gonium/esp8266-dht22-sensor/(threads)

Thread 1 (2017-02-25):

src/main.cpp:17:17: fatal error: DHT.h: No such file or directory

lfrancois, 2017-02-25:
It's my first experience with platformio and with the esp8266 so I am very new to it. When I try to run a platformio run, I got this issue.
```
ludo@idefix:~/repos/esp8266-dht22-sensor % platformio run                                                         
[Fri Feb 24 19:31:40 2017] Processing esp01 (targets: upload, platform: espressif, board: esp01, framework: arduino)
--------------------------------------------------------------------------------------------------------------------------------------
Warning! Platform `espressif` is deprecated and will be removed in the next release! Please use `espressif8266` instead.
Verbose mode can be enabled via `-v, --verbose` option
Collected 25 compatible libraries
Looking for dependencies...
Library Dependency Graph
|-- <ESP8266WiFi> v1.0
|-- <running-average>
|-- <ESP8266WebServer> v1.0
|   |-- <ESP8266WiFi> v1.0
|-- <ESP8266mDNS>
|   |-- <ESP8266WiFi> v1.0
Compiling .pioenvs/esp01/src/main.o
Archiving .pioenvs/esp01/libFrameworkArduinoVariant.a
Indexing .pioenvs/esp01/libFrameworkArduinoVariant.a
Compiling .pioenvs/esp01/FrameworkArduino/Esp.o
Compiling .pioenvs/esp01/FrameworkArduino/FS.o
Compiling .pioenvs/esp01/FrameworkArduino/HardwareSerial.o
src/main.cpp:17:17: fatal error: DHT.h: No such file or directory
#include <DHT.h>
^
compilation terminated.
*** [.pioenvs/esp01/src/main.o] Error 1
===================================================== [ERROR] Took 10.91 seconds =====================================================
ludo@idefix:~/repos/esp8266-dht22-sensor %

```

lfrancois, 2017-02-25:
Installing the library doesn't look to help.
```
ludo@idefix:~/repos/esp8266-dht22-sensor % platformio lib install "DHT22"                                         
Library Storage: /Users/ludo/repos/esp8266-dht22-sensor/.piolibdeps
Looking for DHT22 library in registry
Conflict: More than one library has been found by request {"name": "DHT22"}:
[ ID  ] Name            Compatibility        "Authors": Description
--------------------------------------------------------------------------------------------------------------------------------------
[ 115 ] DHT22            arduino, atmelavr    "Ben Adams, Craig Ringer": Digital-output relative humidity & temperature sensor/module DHT22
[ 58  ] DHT22            energia, timsp430    "Eugene Mamin": Digital-output relative humidity & temperature sensor/module DHT22
Automatically chose the first available library (use `--interactive` option to make a choice)
Found: http://platformio.org/lib/show/115/DHT22
LibraryManager: Installing id=115
Downloading  [####################################]  100%
Unpacking  [####################################]  100%
DHT22 @ 837124f0ce has been successfully installed!
ludo@idefix:~/repos/esp8266-dht22-sensor %
```

lfrancois, 2017-02-25:
```
ludo@idefix:.../esp8266/esp8266-dht22-sensor % git diff
diff --git a/platformio.ini b/platformio.ini
index 123995e..29f0fe5 100644
--- a/platformio.ini
+++ b/platformio.ini
@@ -18,9 +18,10 @@
 # targets = upload

 [env:esp01]
-platform = espressif
+platform = espressif8266
 framework = arduino
 board = esp01
 targets = upload
 # Optimize for binary size
 #build_flags=-Os
+lib_deps = 19
ludo@idefix:.../esp8266/esp8266-dht22-sensor %
```

battlezone100, 2017-04-19:
The project works as is, but you need to manually install the right DHT library. I installed this one in the .platformio/lib folder and then it build just fine: https://github.com/adafruit/DHT-sensor-library

Thread 2 (2017-02-25):

code doesn't upload - warning: espcomm_sync failed

lfrancois, 2017-02-25:
```
ludo@idefix:.../esp8266/esp8266-dht22-sensor % platformio run -t upload                                               
Building .pioenvs/esp01/firmware.bin
Looking for upload port...
Auto-detected: /dev/cu.SLAB_USBtoUART
Uploading .pioenvs/esp01/firmware.bin
warning: espcomm_sync failed
error: espcomm_open failed
error: espcomm_upload_mem failed
*** [upload] Error 255
======================================================= [ERROR] Took 17.42 seconds =======================================================
ludo@idefix:.../esp8266/esp8266-dht22-sensor %
```

lfrancois, 2017-02-25:
Fixed! In changing the board type, I use a NodeMCU board.
```
ludo@idefix:.../esp8266/esp8266-dht22-sensor % git diff                                                                       22:03 #4327
diff --git a/platformio.ini b/platformio.ini
index 123995e..10c0333 100644
--- a/platformio.ini
+++ b/platformio.ini
@@ -18,9 +18,10 @@
 # targets = upload

 [env:esp01]
-platform = espressif
+platform = espressif8266
 framework = arduino
-board = esp01
+board = esp12e
 targets = upload
 # Optimize for binary size
 #build_flags=-Os
+lib_deps = 19
ludo@idefix:.../esp8266/esp8266-dht22-sensor % ```

Thread 4 (2019-09-30):

espressif platform depreciated

haldi4803, 2019-09-30:
Hi,

I tried this nowadays with Windows 10....
VSC and Platformio installation worked fine.
Manually downloading the Code from Github ignores the "DHT-sensor library" in lib folder so you have to extra download and copy that one.
Same goes for Adafruit_Sensor.h which seems to be missing.

After that when you use "Platformio run" you get the message that platform=espressif doesn't exist anymore, so change that to espressif8266.

After that i get some errors:
`Compiling .pio\build\esp01\lib8ee\ESP8266WiFi\ESP8266WiFiScan.cpp.o
lib\DHT-sensor-library\DHT.cpp: In member function 'bool DHT::read(bool)':
lib\DHT-sensor-library\DHT.cpp:29:18: warning: comparison between signed and unsigned integer expressions [-Wsign-compare]
 #define TIMEOUT -1        /**< timeout on */
                  ^
lib\DHT-sensor-library\DHT.cpp:282:29: note: in expansion of macro 'TIMEOUT'
     if (expectPulse(LOW) == TIMEOUT) {
                             ^
lib\DHT-sensor-library\DHT.cpp:29:18: warning: comparison between signed and unsigned integer expressions [-Wsign-compare]
 #define TIMEOUT -1        /**< timeout on */
                  ^
lib\DHT-sensor-library\DHT.cpp:287:30: note: in expansion of macro 'TIMEOUT'
     if (expectPulse(HIGH) == TIMEOUT) {
                              ^
lib\DHT-sensor-library\DHT.cpp:29:18: warning: comparison between signed and unsigned integer expressions [-Wsign-compare]
 #define TIMEOUT -1        /**< timeout on */
                  ^
lib\DHT-sensor-library\DHT.cpp:312:23: note: in expansion of macro 'TIMEOUT'
     if ((lowCycles == TIMEOUT) || (highCycles == TIMEOUT)) {
                       ^
lib\DHT-sensor-library\DHT.cpp:29:18: warning: comparison between signed and unsigned integer expressions [-Wsign-compare]
 #define TIMEOUT -1        /**< timeout on */
                  ^
lib\DHT-sensor-library\DHT.cpp:312:50: note: in expansion of macro 'TIMEOUT'
     if ((lowCycles == TIMEOUT) || (highCycles == TIMEOUT)) {
                                                  ^
Compiling .pio\build\esp01\lib8ee\ESP8266WiFi\WiFiClient.cpp.o`
Full output: https://pastebin.com/qe42bqLV

When i try to connect the Serial Monitor i only get gibberish:

`> Executing task in folder esp8266-dht22-sensor-master: C:\Users\Haldi\.platformio\penv\Scripts\platformio.exe device monitor <

--- Miniterm on COM5  9600,8,N,1 ---
--- Quit: Ctrl+C | Menu: Ctrl+T | Help: Ctrl+T followed by Ctrl+H ---
0�~?�4�Ҷ␖��␔O'�␎��
--- Baudrate: 74880

--- Settings: COM5  74880,8,N,1
--- RTS: active    DTR: active    BREAK: inactive
--- CTS: inactive  DSR: inactive  RI: inactive  CD: inactive
--- software flow control: inactive
--- hardware flow control: inactive
--- serial input encoding: UTF-8
--- serial output encoding: UTF-8
--- EOL: CRLF
--- filters: default
`
Or more like it only outputs a tiny speck right after flashing and nothing more.
I did something wrong yes?
