gonium/esp8266-dht22-sensor/(commit log)

2015-09-20 implemented simple LED switch example - working as expected.
2015-09-20 added adafruit's DHT-sensor-library as a submodule
2015-09-21 added kicad schematic & component libraries
    [sensorpcb.kicad_pcb, sensorpcb.sch]
2015-09-21 added schematic picture to readme
2015-09-23 corrected schematic: R1 and R2 are pullups, not pulldowns!
    [sensorpcb.sch]
2015-09-24 added DS18S20 to the schematic
    [sensorpcb.sch]
2015-09-24 added defines for different sensor types
2015-09-24 updated documentation: now contains DS18S20 hints.
    [sensorpcb.sch]
2015-09-25 sensor now returns 503 w/ error message in case of failures
    [main.cpp]
2015-09-25 added decoupling capacitor to schematic
    [sensorpcb.sch]
2015-10-18 added switch to support DHT11 sensors
2015-10-18 implemented low-pass filter (averaging) of all sensor values
2015-10-31 scanning onewire bus for more than one sensor - still need a multiplexer for the runningaverage class
2015-11-01 now using an array of accumulators - prepped to use more than one sensor.
2015-11-02 implemented status page w/ all sensors listed. plans for JSON api documented in a todo comment.
2015-11-07 implemented URL lambdas for several sensors
2015-11-17 didn't copy change of hostname variable over into sample configuration
    [config_sample.h]
2015-11-22 added esp-wroom-02 to schematic
    [sensorpcb.sch]
2015-11-22 added redirect for /temperature endpoint to first temperature sensor
2015-11-24 documented multiple sensor setup
2015-11-24 updated schematic for website
    [sensorpcb.sch]
